kpreid/3dp-3-axis-coil/3-axis-coil.scad

diameter = 40;
slot_width = 3;
slot_depth = 1.5;
sphere_resolution = 120;
handle_diameter = 10;
handle_wall = 1;
handle_facets = 3;
handle_middle_length = 100;

// jack drawing: Kycon STPX-3501-3C-1 https://www.mouser.com/datasheet/2/222/Kycon_01262018_STPX-3501-3C-1-1283208.pdf
box_side_wall = 0.95;
jack_unit_spacing = 10.5 /* datasheet body size, shield terminal removed */ + 1 /* fudge */;
jack_depth = 9 + 5.60 /* from datasheet */;
jack_panel_hole = 6;
jack_count = 3;
width_margin = 1;
length_margin = 10;
shell_taper_length = 20;
box_interior_width = (jack_unit_spacing + width_margin) * jack_count + width_margin;
box_interior_length = jack_depth + length_margin;
box_exterior_width = box_interior_width + box_side_wall * 2;
box_exterior_length = box_interior_length + box_side_wall * 2;
box_height = 12;  // not bothering to calculate minimum. TODO: rename to box_interior_height

plate_spacing = 5;

epsilon = 0.01;
facet_epsilon = 10;
bigger = 100;
corner_angle = asin(1/sqrt(3));

handle_socket_taper_large = handle_diameter + 0.4;
handle_socket_taper_small = handle_diameter;
handle_shaft_length = handle_middle_length + diameter * 0.75;

plate();
//junction_box();

module plate() {
    half(true);
    translate([diameter + plate_spacing, 0, 0]) half(false);
    translate([0, (diameter + handle_diameter) / 2 + plate_spacing, 0]) handle();
    translate([-diameter / 2 - plate_spacing, 0, 0]) rotate([0, 0, 180]) junction_box();
    translate([0, -(diameter / 2 + box_exterior_width) - plate_spacing, 0]) junction_box_cover();
}

module handle() {
    translate([0, 0, cos(60) * handle_diameter / 2])
    rotate([0, -90, 0]) {
        difference() {
            cylinder(d=handle_diameter, h=handle_shaft_length, $fn=handle_facets, center=true);
            cylinder(
                d=handle_diameter - handle_wall * 2,
                h=handle_shaft_length + epsilon * 2,
                $fn=handle_facets,
                center=true);
        }
    }
}

module handle_hole(h, taper_1, taper_2, center=false) {
    cylinder(
        d1=taper_1 ? handle_socket_taper_small : handle_socket_taper_large,
        d2=taper_2 ? handle_socket_taper_small : handle_socket_taper_large,
        h=h,
        $fn=handle_facets,
        center=center);
}

module half(is_top_half) {
    difference() {
        rotate([0, 0, is_top_half ? 0 : 180])  // align coil slots given handle hole
        coil_sphere(is_top_half);

        // remove opposite half
        mirror([0, 0, 1])
        top_half_enclosing();
        
        // punch hole for handle
        translate([0, 0, -epsilon])
        rotate([0, 0, -30])
        handle_hole(diameter / 2 + epsilon * 2, false, is_top_half);
    }
}


module coil_sphere(include_entry) {
    difference() {
        sphere(d=diameter, $fn=sphere_resolution);
        
        coil_slot_and_entry(include_entry);
        rotate([0, 0, 120]) coil_slot_and_entry(include_entry);
        rotate([0, 0, -120]) coil_slot_and_entry(include_entry);
    }
}

module coil_slot() {
    linear_extrude(slot_width, center=true, $fn=sphere_resolution, convexity=3)
    difference() {
        circle(d=diameter + facet_epsilon);
        circle(d=diameter - slot_depth * 2);
    }
}

module coil_slot_and_entry(include_entry) {
    rotate([90 - corner_angle, 0, 0])
    coil_slot();
    
    if (include_entry)
    render()  // faster preview
    intersection() {
        // perpendicular slot
        rotate([0, 90, 0]) coil_slot();
        
        // cut part "below" main slot
        rotate([90 - corner_angle, 0, 0])
        top_half_enclosing();
        
        // cut part beyond the middle
        rotate([-90, 0, 0]) top_half_enclosing();
    }
}

module top_half_enclosing() {
    cylinder(d=diameter * 2, h=diameter, $fn=4);
}

module junction_box() {
    // coordinates: length/x, width/y, height/z
    
    translate([0, 0, box_height / 2 + box_side_wall])
    difference() {
        minkowski() {
            sphere(r=box_side_wall, $fn=8);
            
            hull() {
                jack_volume_form();
                

                translate([box_interior_length + shell_taper_length, 0, 0])
                cube([epsilon, box_height, box_height], center=true);
            }
        }
        
        jack_volume_form();
        
        // cut off top TEMPORARY FOR DEVELOPMENT we need a real panel eventually
        translate([0, 0, 10]) jack_volume_form();
        
        // jack holes
        for (i = [-1:1]) {
            translate([epsilon, i * jack_unit_spacing, 0])
            rotate([0, -90, 0])
            cylinder(d=jack_panel_hole, h=box_side_wall * 3, $fn=20);
        }
        
        translate([box_interior_length - epsilon, 0, 0])
        mirror([1, 0, 0])
        rotate([0, -90, 0])
        handle_hole(shell_taper_length + box_side_wall + epsilon, true, false);
    }
}

module junction_box_cover() {
    jack_distance_to_top = 2.3;  // necessarily fudgey; too big is better than too small
    
    cube([box_interior_length, box_interior_width, jack_distance_to_top]);
    linear_extrude(box_height + box_side_wall) {
        corner_peg();
        translate([0, box_interior_width, 0]) mirror([0, 1, 0]) corner_peg();
    }
    
    module corner_peg() {
        polygon([
            [0, 0],
            [5, 0],
            [2, 2],
            [0, 5],
        ]);
    }
}

    
module jack_volume_form() {
    translate([0, -box_interior_width / 2, -box_height / 2])
    cube([box_interior_length, box_interior_width, box_height]);
}
