kpreid/3dp-3-axis-coil/(commit log)

2019-04-06 First sketch.
    [3-axis-coil.scad]
2019-04-06 Cut for printability.
    [3-axis-coil.scad]
2019-04-07 Relayout for wire grooves towards center.
    [3-axis-coil.scad]
2019-04-07 New plan: handle is printed and wedged in, and handle is a triangle as a handling reference.
    [3-axis-coil.scad]
2019-04-07 handle design
    [3-axis-coil.scad]
2019-04-07 start sketching in connector box
    [3-axis-coil.scad]
2019-04-07 Handle panel holes, taper
    [3-axis-coil.scad]
2019-04-07 minkowski style box (not printable yet)
    [3-axis-coil.scad]
2019-04-07 Quickly prep for test print.
    [3-axis-coil.scad]
2019-04-08 Fix Z height to make plate actually printable.
    [3-axis-coil.scad]
2019-04-08 Design cover plate for jack box.
    [3-axis-coil.scad]
2019-04-08 Fix meaning of slot_depth. No geometry changed.
    [3-axis-coil.scad]
2019-04-10 Fix height of cover pegs so cover will be flush.
    [3-axis-coil.scad]
